CodeOnSunday/MacroPad-HW/Keyboard/keyboard.kicad_pcb

## KiCad design Keyboard/keyboard.kicad_pcb (2025-05-13)

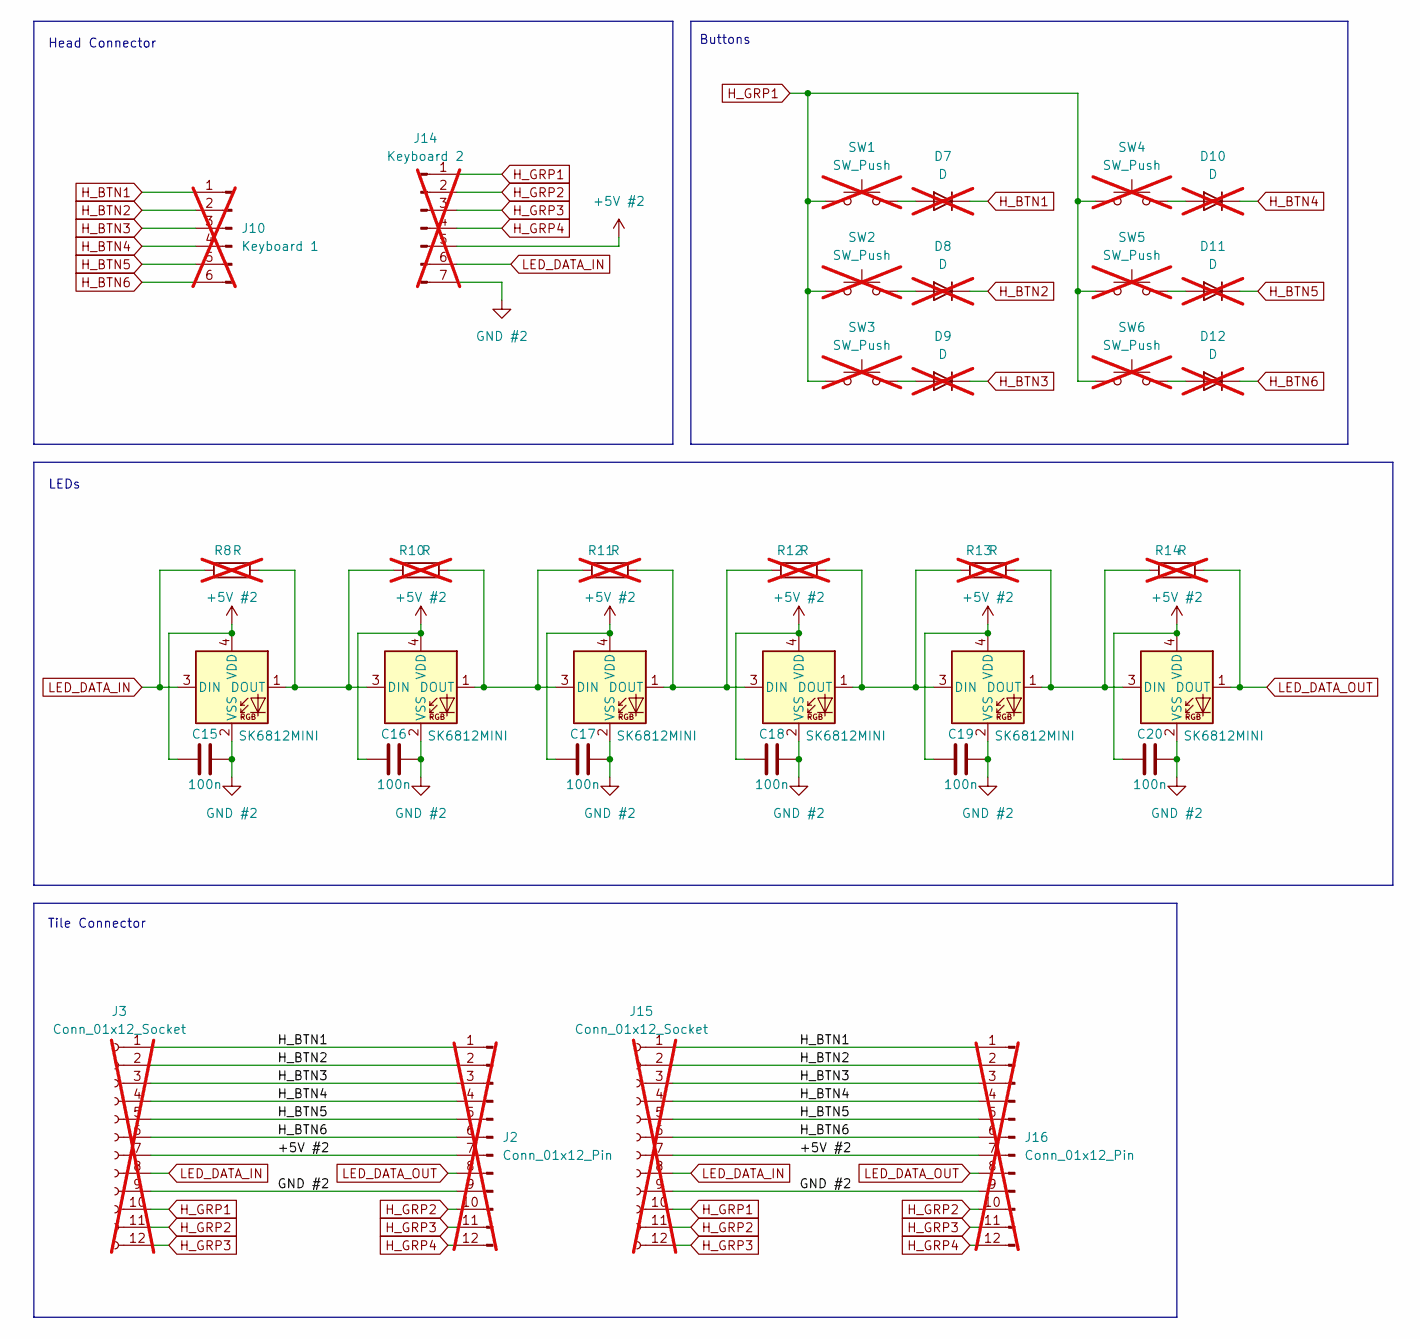
[picture p1: schematic keyboard.kicad_sch]

Parts:
C15, C16, C17, C18, C19, C20: 100n; C_0603_1608Metric
D1, D2, D3, D4, D5, D6: SK6812MINI; LED_SK6812MINI_PLCC4_3.5x3.5mm_P1.75mm
D7, D8, D9, D10, D11, D12: D; D_0603_1608Metric; not fitted
J2, J16: Conn_01x12_Pin; PinHeader_1x12_P2.54mm_Horizontal; not fitted
J3, J15: Conn_01x12_Socket; PinSocket_1x12_P2.54mm_Horizontal; not fitted
J10: Keyboard 1; PinHeader_1x06_P2.54mm_Vertical; not fitted
J14: Keyboard 2; PinHeader_1x07_P2.54mm_Vertical; not fitted
R8, R10, R11, R12, R13, R14: R; R_0603_1608Metric; not fitted
SW1, SW2, SW3, SW4, SW5, SW6: SW_Push; Gateron Pro; not fitted

Connections:
+5V #2: C15.2, C16.2, C17.2, C18.2, C19.2, C20.2, D1.4 (VDD), D2.4 (VDD), D3.4 (VDD), D4.4 (VDD), D5.4 (VDD), D6.4 (VDD), J2.7, J3.7, J14.5, J15.7, J16.7
GND #2: C15.1, C16.1, C17.1, C18.1, C19.1, C20.1, D1.2 (VSS), D2.2 (VSS), D3.2 (VSS), D4.2 (VSS), D5.2 (VSS), D6.2 (VSS), J2.9, J3.9, J14.7, J15.9, J16.9
H_BTN1: D7.1 (K), J2.1, J3.1, J10.1, J15.1, J16.1
H_BTN2: D8.1 (K), J2.2, J3.2, J10.2, J15.2, J16.2
H_BTN3: D9.1 (K), J2.3, J3.3, J10.3, J15.3, J16.3
H_BTN4: D10.1 (K), J2.4, J3.4, J10.4, J15.4, J16.4
H_BTN5: D11.1 (K), J2.5, J3.5, J10.5, J15.5, J16.5
H_BTN6: D12.1 (K), J2.6, J3.6, J10.6, J15.6, J16.6
H_GRP1: J3.10, J14.1, J15.10, SW1.1, SW2.1, SW3.1, SW4.1, SW5.1, SW6.1
H_GRP2: J2.10, J3.11, J14.2, J15.11, J16.10
H_GRP3: J2.11, J3.12, J14.3, J15.12, J16.11
H_GRP4: J2.12, J14.4, J16.12
LED_DATA_IN: D1.3 (DIN), J3.8, J14.6, J15.8, R8.1
LED_DATA_OUT: D6.1 (DOUT), J2.8, J16.8, R14.2
unnamed: D1.1 (DOUT), D2.3 (DIN), R8.2, R10.1
unnamed: D2.1 (DOUT), D3.3 (DIN), R10.2, R11.1
unnamed: D3.1 (DOUT), D4.3 (DIN), R11.2, R12.1
unnamed: D4.1 (DOUT), D5.3 (DIN), R12.2, R13.1
unnamed: D5.1 (DOUT), D6.3 (DIN), R13.2, R14.1
unnamed: D7.2 (A), SW1.2
unnamed: D8.2 (A), SW2.2
unnamed: D9.2 (A), SW3.2
unnamed: D10.2 (A), SW4.2
unnamed: D11.2 (A), SW5.2
unnamed: D12.2 (A), SW6.2

Notes on the sheet:
Head Connector
LEDs
Tile Connector
Buttons

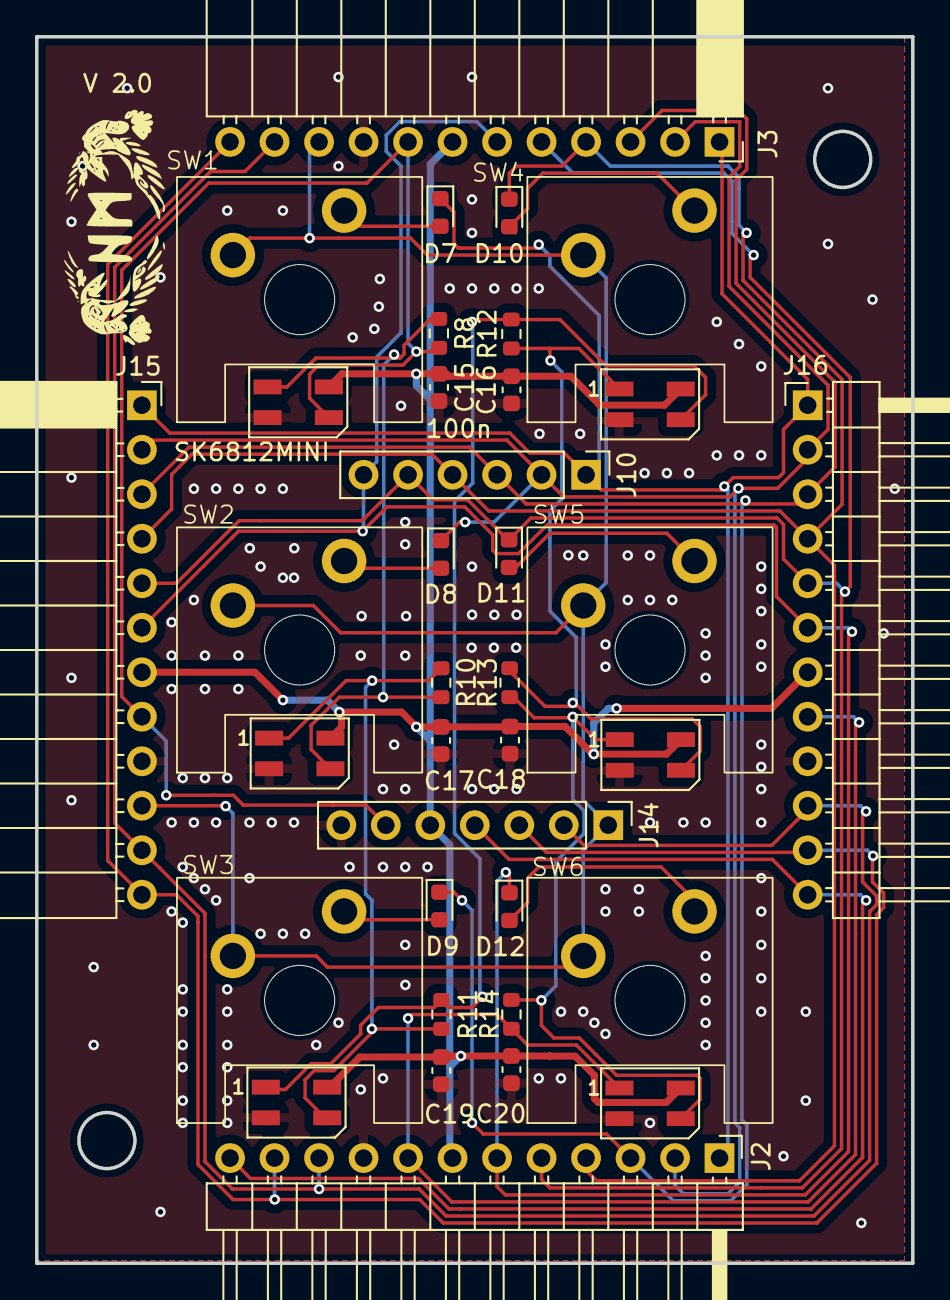
[picture p2: board keyboard.kicad_pcb from above]

Board: 2 copper layers, 50.0 x 70.0 mm, 36 parts (0 on the bottom side), 25 nets.
