CodeOnSunday/MacroPad-HW/Mainboard/macropad.kicad_pcb

## KiCad design Mainboard/macropad.kicad_pcb (2025-05-13)

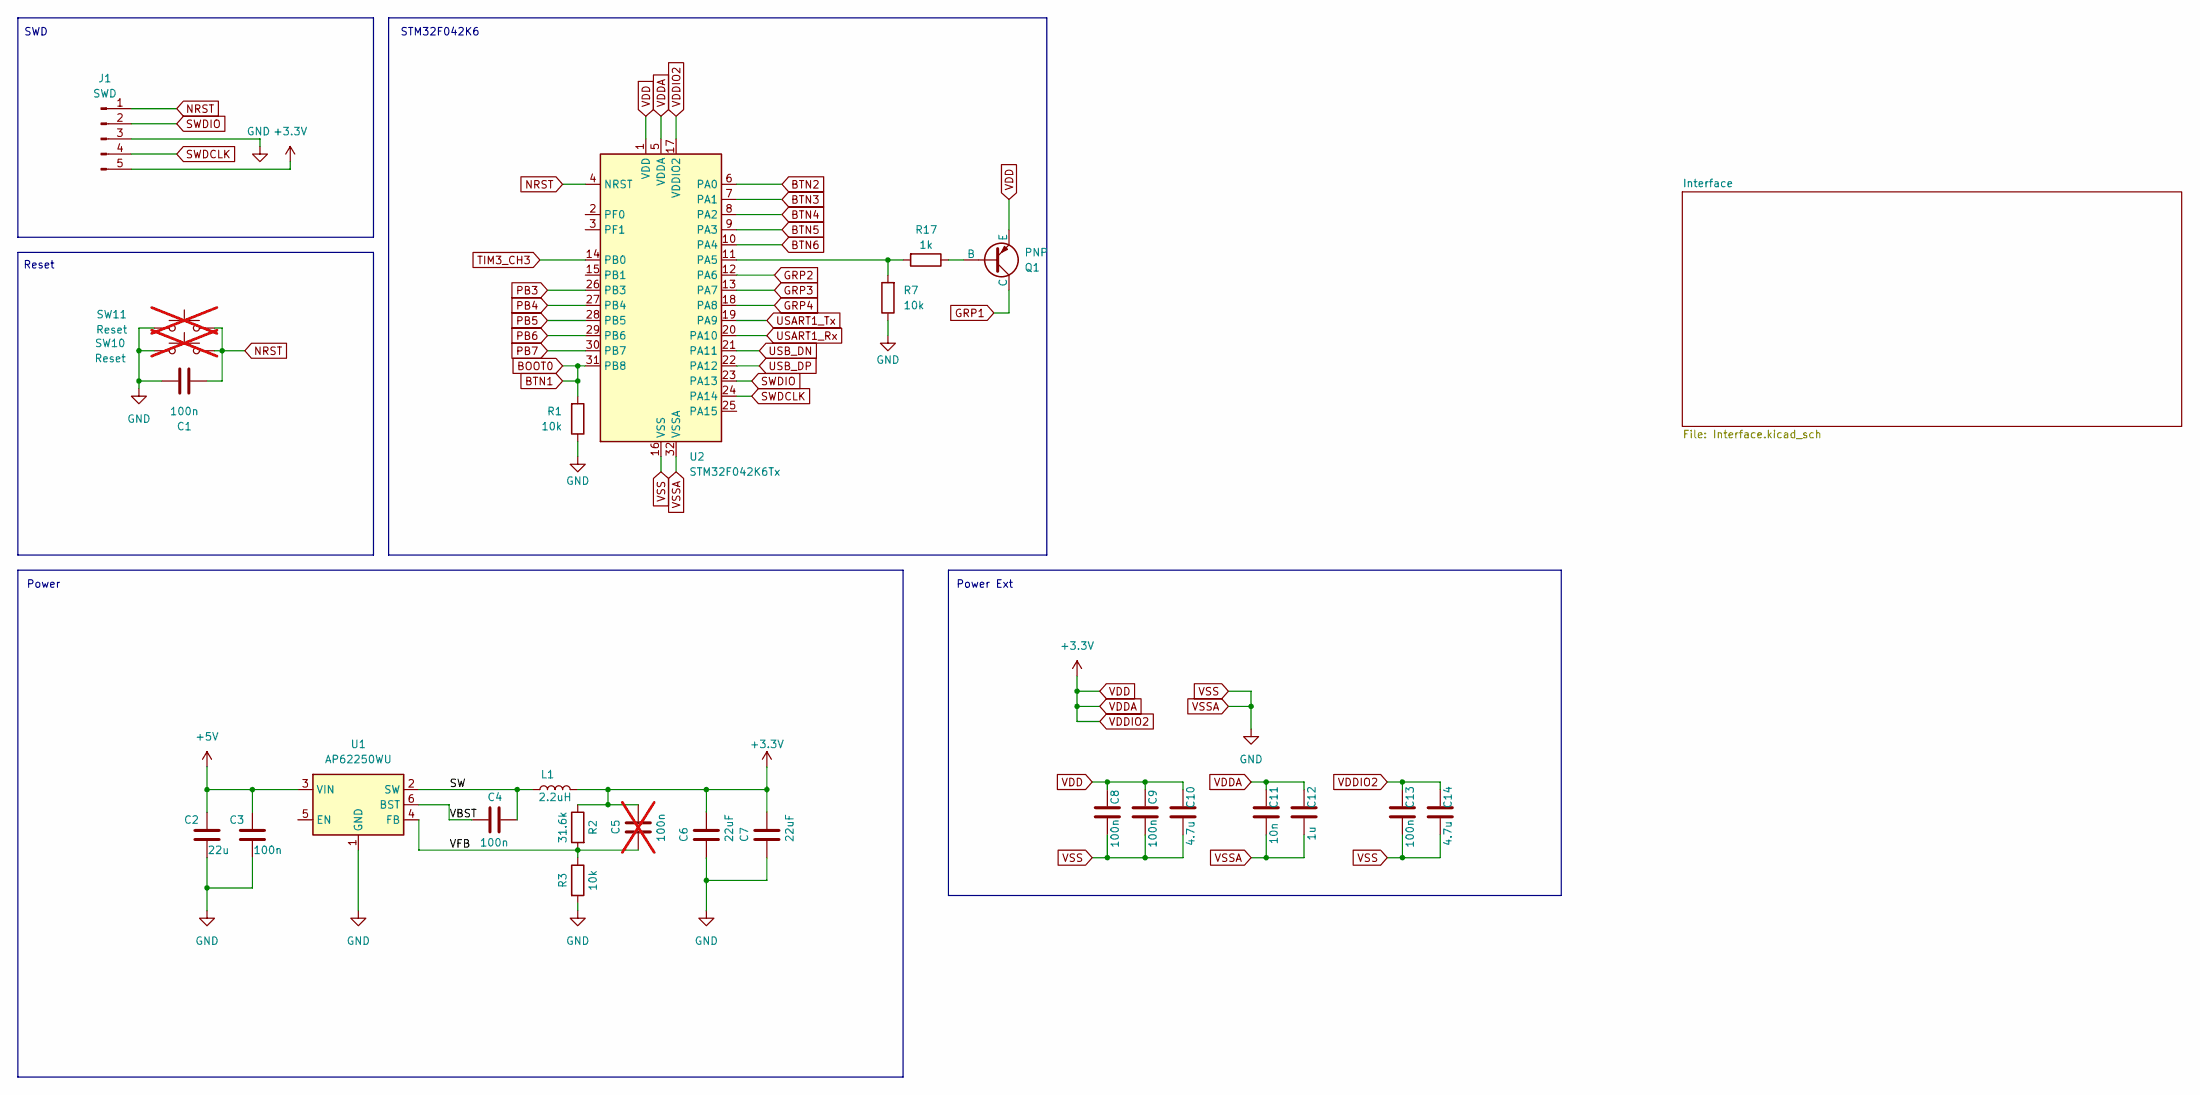
[picture p3: schematic macropad.kicad_sch, MCU]

Parts:
C1, C3, C4, C8, C9, C13: 100n; C_0603_1608Metric
C2: 22u; C_1206_3216Metric
C5: 100n; C_0603_1608Metric; not fitted
C6, C7: 22uF; C_1206_3216Metric
C10, C14: 4.7u; C_1206_3216Metric
C11: 10n; C_0603_1608Metric
C12: 1u; C_1206_3216Metric
J1: SWD; Conn_Edge_x05
L1: 2.2uH; L_Taiyo-Yuden_NR-50xx
Q1: PNP; SOT-23
R1, R7: 10k; R_0805_2012Metric_Pad1.20x1.40mm_HandSolder
R2: 31.6k; R_0603_1608Metric
R3: 10k; R_0603_1608Metric
R17: 1k; R_0805_2012Metric_Pad1.20x1.40mm_HandSolder
SW10, SW11: Reset; SW_SPST_B3U-1000P; not fitted
U1: AP62250WU; TSOT-23-6
U2: STM32F042K6Tx; LQFP-32_7x7mm_P0.8mm

Connections:
+5V: C2.1, C3.1, U1.3 (VIN); also elsewhere on the board
/SW: C4.1, L1.1, U1.2 (SW)
/VBST: C4.2, U1.6 (BST)
/VFB: C5.2, R2.2, R3.1, U1.4 (FB)
BOOT0: R1.2, U2.31 (PB8); also elsewhere on the board
BTN2: U2.6 (PA0); also elsewhere on the board
BTN3: U2.7 (PA1); also elsewhere on the board
BTN4: U2.8 (PA2); also elsewhere on the board
BTN5: U2.9 (PA3); also elsewhere on the board
BTN6: U2.10 (PA4); also elsewhere on the board
GRP1: Q1.1 (C); also elsewhere on the board
GRP2: U2.12 (PA6); also elsewhere on the board
GRP3: U2.13 (PA7); also elsewhere on the board
GRP4: U2.18 (PA8); also elsewhere on the board
NRST: C1.1, J1.1, SW10.2, SW11.2, U2.4 (NRST)
unnamed: Q1.2 (B), R17.1
unnamed: R7.2, R17.2, U2.11 (PA5)
PB3: U2.26 (PB3); also elsewhere on the board
PB4: U2.27 (PB4); also elsewhere on the board
PB5: U2.28 (PB5); also elsewhere on the board
PB6: U2.29 (PB6); also elsewhere on the board
PB7: U2.30 (PB7); also elsewhere on the board
SWDCLK: J1.4, U2.24 (PA14)
SWDIO: J1.2, U2.23 (PA13)
TIM3_CH3: U2.14 (PB0); also elsewhere on the board
USART1_Rx: U2.20 (PA10); also elsewhere on the board
USART1_Tx: U2.19 (PA9); also elsewhere on the board
USB_DN: U2.21 (PA11); also elsewhere on the board
USB_DP: U2.22 (PA12); also elsewhere on the board
VDD: C5.1, C6.1, C7.1, C8.2, C9.2, C10.2, C11.2, C12.2, C13.2, C14.2, J1.5, L1.2, Q1.3 (E), R2.1, U2.1 (VDD), U2.5 (VDDA), U2.17 (VDDIO2); also elsewhere on the board
VSS: C1.2, C2.2, C3.2, C6.2, C7.2, C8.1, C9.1, C10.1, C11.1, C12.1, C13.1, C14.1, J1.3, R1.1, R3.2, R7.1, SW10.1, SW11.1, U1.1 (GND), U2.16 (VSS), U2.32 (VSSA); also elsewhere on the board

Notes on the sheet:
Power Ext
Power
STM32F042K6
Reset
SWD

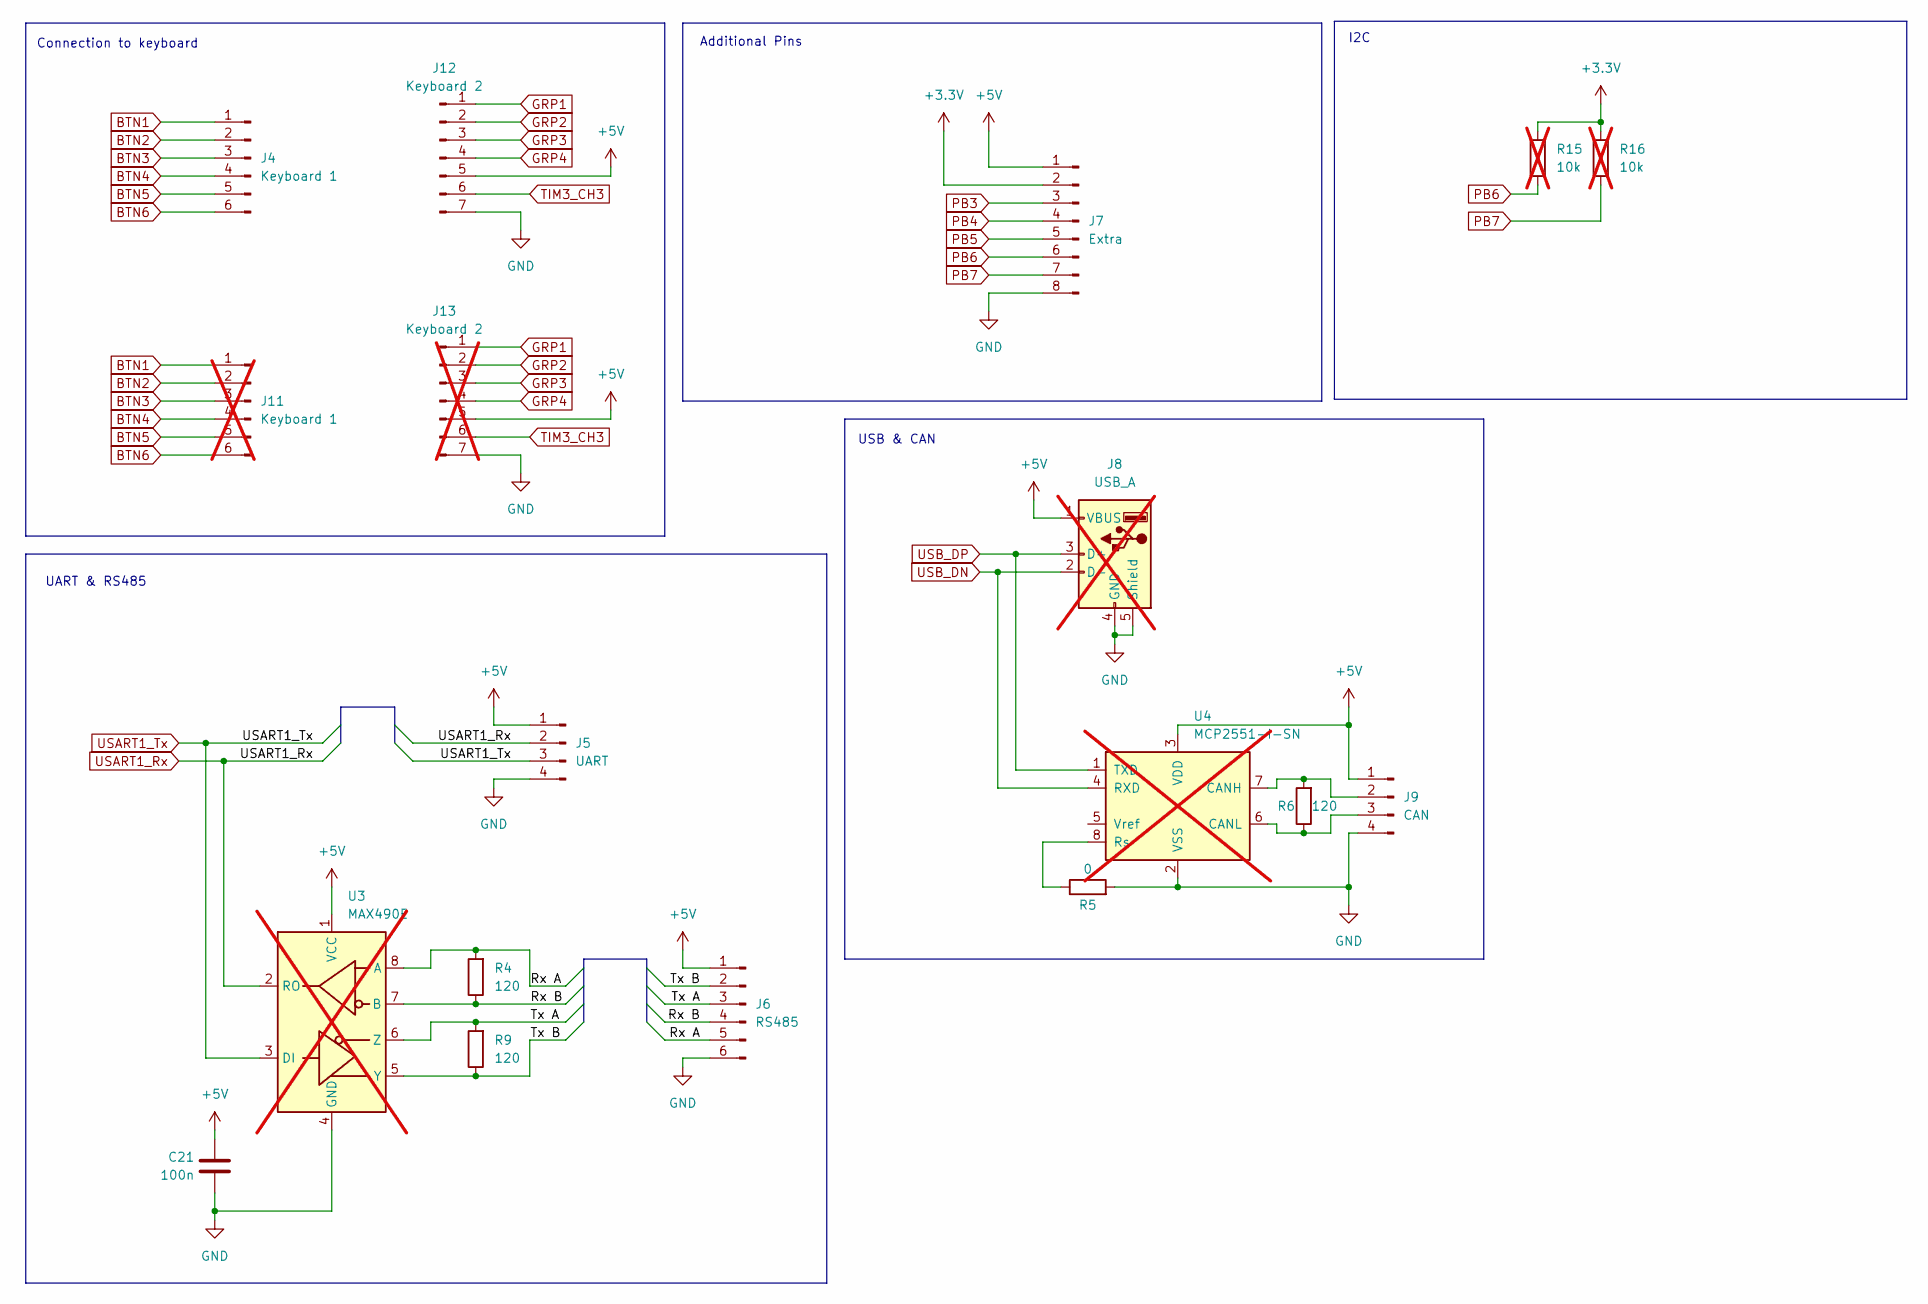
[picture p4: schematic Interface.kicad_sch]

Parts:
C21: 100n; C_0603_1608Metric
J4: Keyboard 1; PinHeader_1x06_P2.54mm_Vertical_SMD_Pin1Left
J5: UART; Conn_Edge_x04
J6: RS485; Conn_Edge_x06
J7: Extra; Conn_Edge_x08
J8: USB_A; USB_Micro-B_Wuerth_629105150521_CircularHoles; not fitted
J9: CAN; Conn_Edge_x04
J11: Keyboard 1; PinHeader_1x06_P2.54mm_Vertical; not fitted
J12: Keyboard 2; PinHeader_1x07_P2.54mm_Vertical_SMD_Pin1Left
J13: Keyboard 2; PinHeader_1x07_P2.54mm_Vertical; not fitted
R4, R6, R9: 120; R_0805_2012Metric_Pad1.20x1.40mm_HandSolder
R5: 0; R_0603_1608Metric
R15, R16: 10k; R_0805_2012Metric_Pad1.20x1.40mm_HandSolder; not fitted
U3: MAX490E; SOIC-8_3.9x4.9mm_P1.27mm; not fitted
U4: MCP2551-I-SN; SOIC-8_3.9x4.9mm_P1.27mm; not fitted

Connections:
+5V: C21.1, J5.1, J6.1, J7.1, J8.1 (VBUS), J9.1, J12.5, J13.5, U3.1 (VCC), U4.3 (VDD); also elsewhere on the board
/Interface/Rx A: J6.5, R4.2, U3.8 (A)
/Interface/Rx B: J6.4, R4.1, U3.7 (B)
/Interface/Tx A: J6.3, R9.2, U3.6 (Z)
/Interface/Tx B: J6.2, R9.1, U3.5 (Y)
BOOT0: J4.1, J11.1; also elsewhere on the board
BTN2: J4.2, J11.2; also elsewhere on the board
BTN3: J4.3, J11.3; also elsewhere on the board
BTN4: J4.4, J11.4; also elsewhere on the board
BTN5: J4.5, J11.5; also elsewhere on the board
BTN6: J4.6, J11.6; also elsewhere on the board
GRP1: J12.1, J13.1; also elsewhere on the board
GRP2: J12.2, J13.2; also elsewhere on the board
GRP3: J12.3, J13.3; also elsewhere on the board
GRP4: J12.4, J13.4; also elsewhere on the board
unnamed: J9.2, R6.2, U4.7 (CANH)
unnamed: J9.3, R6.1, U4.6 (CANL)
unnamed: R5.1, U4.8 (Rs)
PB3: J7.3; also elsewhere on the board
PB4: J7.4; also elsewhere on the board
PB5: J7.5; also elsewhere on the board
PB6: J7.6, R15.1; also elsewhere on the board
PB7: J7.7, R16.1; also elsewhere on the board
TIM3_CH3: J12.6, J13.6; also elsewhere on the board
USART1_Rx: J5.2, U3.2 (RO); also elsewhere on the board
USART1_Tx: J5.3, U3.3 (DI); also elsewhere on the board
USB_DN: J8.2 (D-), U4.4 (RXD); also elsewhere on the board
USB_DP: J8.3 (D+), U4.1 (TXD); also elsewhere on the board
VDD: J7.2, R15.2, R16.2; also elsewhere on the board
VSS: C21.2, J5.4, J6.6, J7.8, J8.4 (GND), J8.5 (Shield), J9.4, J12.7, J13.7, R5.2, U3.4 (GND), U4.2 (VSS); also elsewhere on the board

Notes on the sheet:
I2C
Additional Pins
UART & RS485
USB & CAN
Connection to keyboard

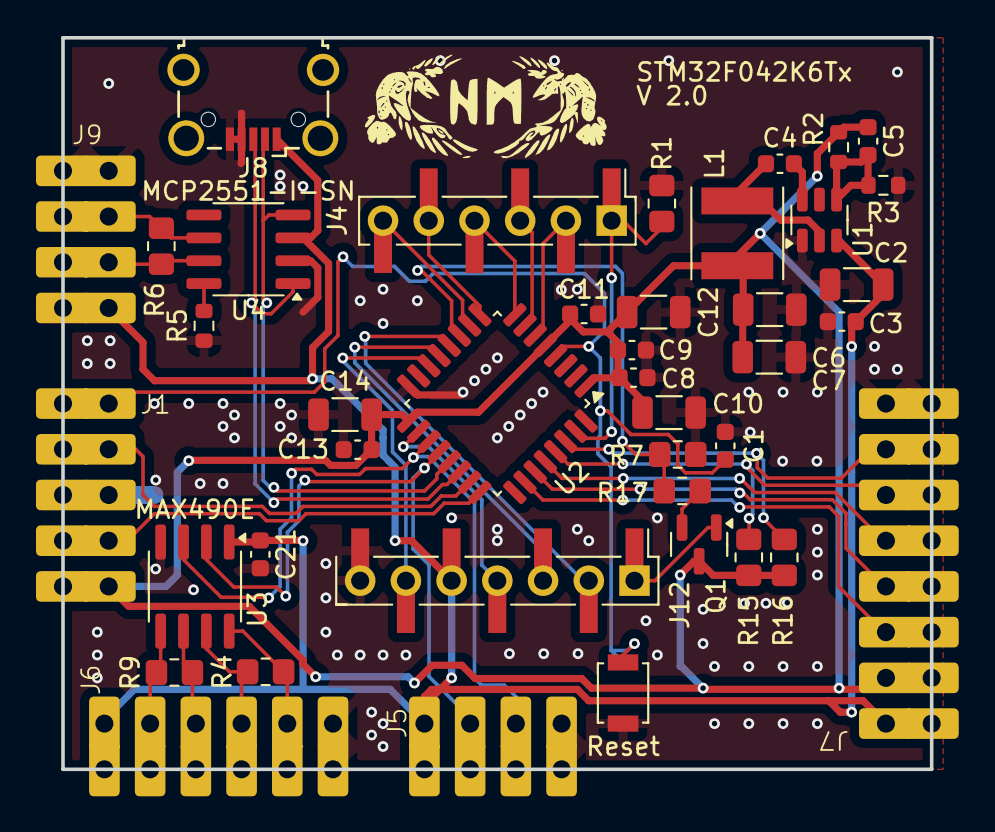
[picture p5: board macropad.kicad_pcb from above]

Board: 2 copper layers, 48.3 x 40.6 mm, 44 parts (1 on the bottom side), 38 nets.
