CodeOnSunday/MacroPad-HW/(threads)

Thread 1 (2025-05-13):

Silkscreen error - BOT CAN

CodeOnSunday, 2025-05-13:
The pin description of the bottom silkscreen for the CAN port is in reverse order.

Closed 2025-05-13.

Thread 3 (2025-05-13):

Wrong npn transistor symbol and footprint

CodeOnSunday, 2025-05-13:
