CodeOnSunday/MacroPad-HW/(commit log)

2025-04-15 Version 1.0 Initial commit
    [Interface.kicad_sch, keyboard.kicad_sch, macropad.kicad_pcb, macropad.kicad_sch]
2025-04-15 - Created head board tilable up to 4x - Placed and routed lines ToDo: - Print - I2C reanbable
    [Interface.kicad_sch, keyboard.kicad_sch, macropad.kicad_pcb, macropad.kicad_sch]
2025-04-16 - Silkscreen positions fixed
    [macropad.kicad_pcb]
2025-04-16 - Added Pull Ups for I2C - Added second reset button on bottom side
    [Interface.kicad_sch, macropad.kicad_pcb, macropad.kicad_sch]
2025-04-16 - fixed error in transistor circuit - fixed orientation of silkscreen text - DRC: Okay
    [macropad.kicad_pcb, macropad.kicad_sch]
2025-04-16 - Moved component name to silkscreen - Added version notation to boards
    [macropad.kicad_pcb]
2025-04-18 - Added missing library files to git - Added logo to silkscreen - ERC: Okay
    [Interface.kicad_sch, keyboard.kicad_sch, macropad.kicad_pcb, macropad.kicad_sch]
2025-04-20 Separated Keyboard schematic and pcb to a separate project in the same folder.
    [Interface.kicad_pcb, macropad.kicad_pcb, macropad.kicad_sch]
2025-05-13 Cleaned up project structure.
    [Interface.kicad_sch, keyboard.kicad_pcb, keyboard.kicad_sch, macropad.kicad_pcb, macropad.kicad_sch]
